bclswl0827/2k1000la-cape/hardware/pcb/gerber/pcb-PTH-drl_map.dxf

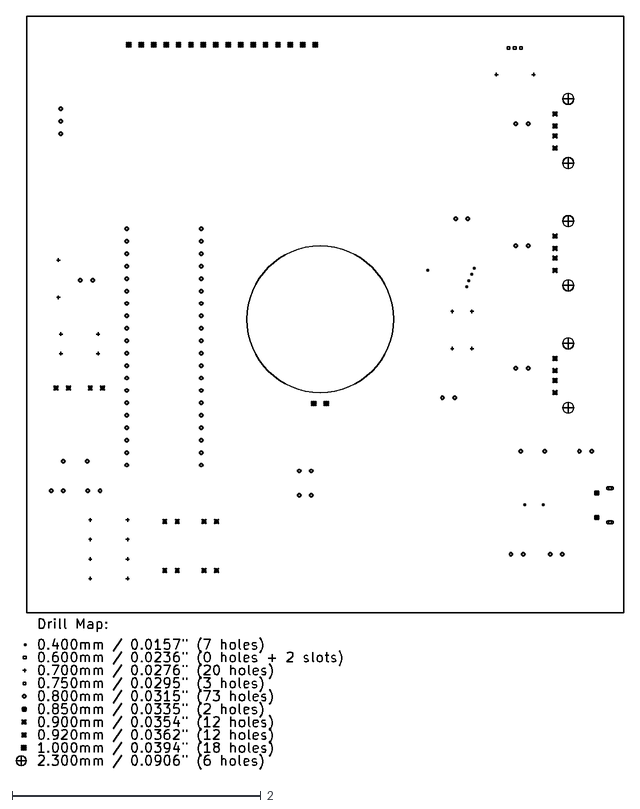
[picture p1: CAD file, 2024-06-12]
hardware/pcb/gerber/pcb-PTH-drl_map.dxf
4.88 x 6.06
