bclswl0827/2k1000la-cape/hardware/pcb/gerber/pcb-NPTH-drl_map.dxf

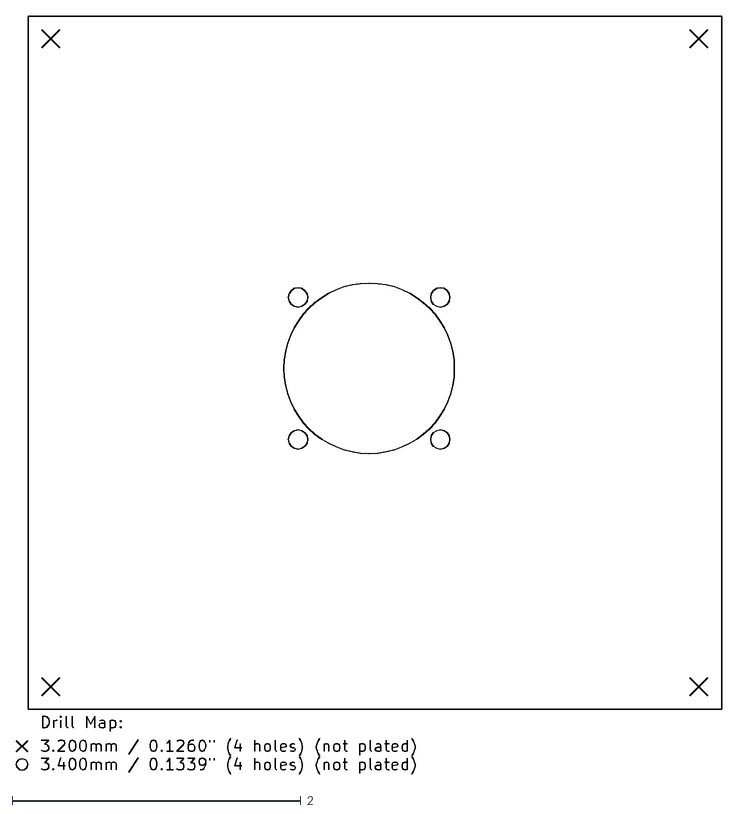
[picture p2: CAD file, 2024-06-12]
hardware/pcb/gerber/pcb-NPTH-drl_map.dxf
4.88 x 5.25
