bclswl0827/2k1000la-cape/hardware/pcb/pcb.kicad_pcb

## KiCad design hardware/pcb/pcb.kicad_pcb (2024-06-21)

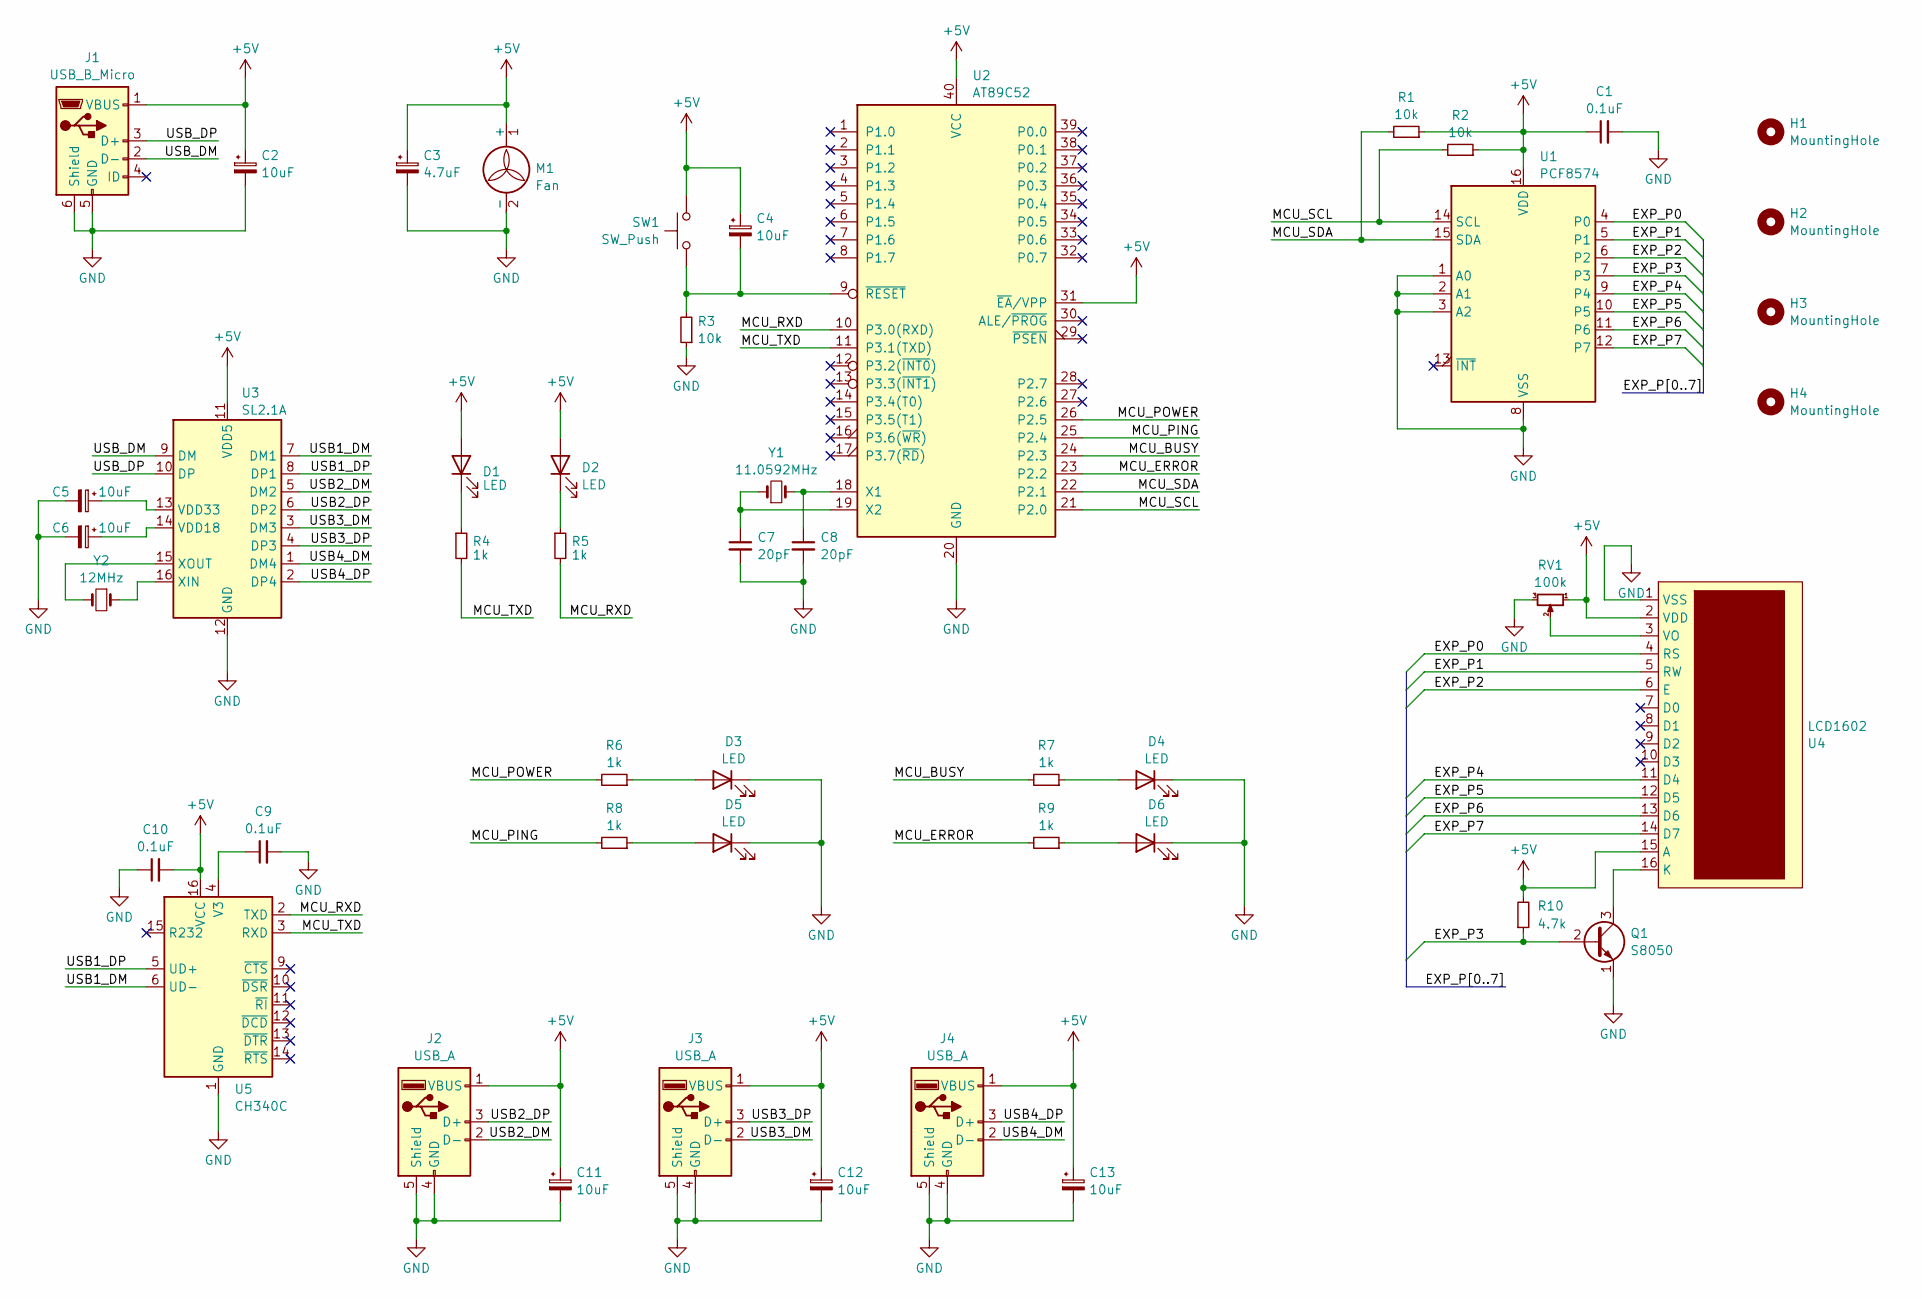
[picture p3: schematic pcb.kicad_sch]

Parts:
C1, C9, C10: 0.1uF; C_Disc_D3.0mm_W2.0mm_P2.50mm
C2, C4, C5, C6, C11, C12, C13: 10uF; CP_Radial_D5.0mm_P2.50mm
C3: 4.7uF; CP_Radial_D5.0mm_P2.50mm
C7, C8: 20pF; C_Disc_D3.0mm_W2.0mm_P2.50mm
D1, D2, D3, D4, D5, D6: LED; LED_D3.0mm
H1, H2, H3, H4: MountingHole; MountingHole_3.2mm_M3
J1: USB_B_Micro; USB_Micro-B_Molex-105017-0001
J2, J3, J4: USB_A; USB_A_CONNFLY_DS1095-WNR0
M1: Fan; Fan_30x30mm
Q1: S8050; TO-92_Inline
R1, R2, R3: 10k; R_Axial_DIN0204_L3.6mm_D1.6mm_P7.62mm_Horizontal
R4, R5, R6, R7, R8, R9: 1k; R_Axial_DIN0204_L3.6mm_D1.6mm_P7.62mm_Horizontal
R10: 4.7k; R_Axial_DIN0204_L3.6mm_D1.6mm_P7.62mm_Horizontal
RV1: 100k; Potentiometer_Bourns_3296W_Vertical
SW1: SW_Push; SW_SPST_FSMSM
U1: PCF8574; SOIC-16W_7.5x10.3mm_P1.27mm
U2: AT89C52; DIP-40_W15.24mm
U3: SL2.1A; SOIC-16_3.9x9.9mm_P1.27mm
U4: LCD1602; PinSocket_1x16_P2.54mm_Vertical
U5: CH340C; SOIC-16_3.9x9.9mm_P1.27mm
Y1: 11.0592MHz; Crystal_HC18-U_Vertical
Y2: 12MHz; Crystal_HC18-U_Vertical

Connections:
+5V: C1.1, C2.1, C3.1, C4.1, C10.2, C11.1, C12.1, C13.1, D1.2 (A), D2.2 (A), J1.1 (VBUS), J2.1 (VBUS), J3.1 (VBUS), J4.1 (VBUS), M1.1 (+), R1.1, R2.1, R10.2, RV1.1, SW1.1, U1.16 (VDD), U2.31 (~EA/VPP), U2.40 (VCC), U3.11 (VDD5), U4.2 (VDD), U4.15 (A), U5.16 (VCC)
/EXP_P0: U1.4 (P0), U4.4 (RS)
/EXP_P1: U1.5 (P1), U4.5 (RW)
/EXP_P2: U1.6 (P2), U4.6 (E)
/EXP_P3: Q1.2 (B), R10.1, U1.7 (P3)
/EXP_P4: U1.9 (P4), U4.11 (D4)
/EXP_P5: U1.10 (P5), U4.12 (D5)
/EXP_P6: U1.11 (P6), U4.13 (D6)
/EXP_P7: U1.12 (P7), U4.14 (D7)
/MCU_BUSY: R7.2, U2.24 (P2.3)
/MCU_ERROR: R9.2, U2.23 (P2.2)
/MCU_PING: R8.2, U2.25 (P2.4)
/MCU_POWER: R6.2, U2.26 (P2.5)
/MCU_RXD: R5.2, U2.10 (P3.0(RXD)), U5.2 (TXD)
/MCU_SCL: R2.2, U1.14 (SCL), U2.21 (P2.0)
/MCU_SDA: R1.2, U1.15 (SDA), U2.22 (P2.1)
/MCU_TXD: R4.2, U2.11 (P3.1(TXD)), U5.3 (RXD)
/USB1_DM: U3.7 (DM1), U5.6 (UD-)
/USB1_DP: U3.8 (DP1), U5.5 (UD+)
/USB2_DM: J2.2 (D-), U3.5 (DM2)
/USB2_DP: J2.3 (D+), U3.6 (DP2)
/USB3_DM: J3.2 (D-), U3.3 (DM3)
/USB3_DP: J3.3 (D+), U3.4 (DP3)
/USB4_DM: J4.2 (D-), U3.1 (DM4)
/USB4_DP: J4.3 (D+), U3.2 (DP4)
/USB_DM: J1.2 (D-), U3.9 (DM)
/USB_DP: J1.3 (D+), U3.10 (DP)
GND: C1.2, C2.2, C3.2, C5.2, C6.2, C7.2, C8.2, C9.2, C10.1, C11.2, C12.2, C13.2, D3.1 (K), D4.1 (K), D5.1 (K), D6.1 (K), J1.5 (GND), J1.6 (Shield), J2.4 (GND), J2.5 (Shield), J3.4 (GND), J3.5 (Shield), J4.4 (GND), J4.5 (Shield), M1.2 (-), Q1.1 (E), R3.1, RV1.3, U1.1 (A0), U1.2 (A1), U1.3 (A2), U1.8 (VSS), U2.20 (GND), U3.12 (GND), U4.1 (VSS), U5.1 (GND)
unnamed: D1.1 (K), R4.1
unnamed: D2.1 (K), R5.1
unnamed: D3.2 (A), R6.1
unnamed: D4.2 (A), R7.1
unnamed: D5.2 (A), R8.1
unnamed: D6.2 (A), R9.1
unnamed: Q1.3 (C), U4.16 (K)
unnamed: C8.1, U2.18 (X1), Y1.2
unnamed: C7.1, U2.19 (X2), Y1.1
unnamed: C4.2, R3.2, SW1.2, U2.9 (~RESET)
unnamed: C6.1, U3.14 (VDD18)
unnamed: C5.1, U3.13 (VDD33)
unnamed: U3.16 (XIN), Y2.1
unnamed: U3.15 (XOUT), Y2.2
unnamed: RV1.2, U4.3 (VO)
unnamed: C9.1, U5.4 (V3)

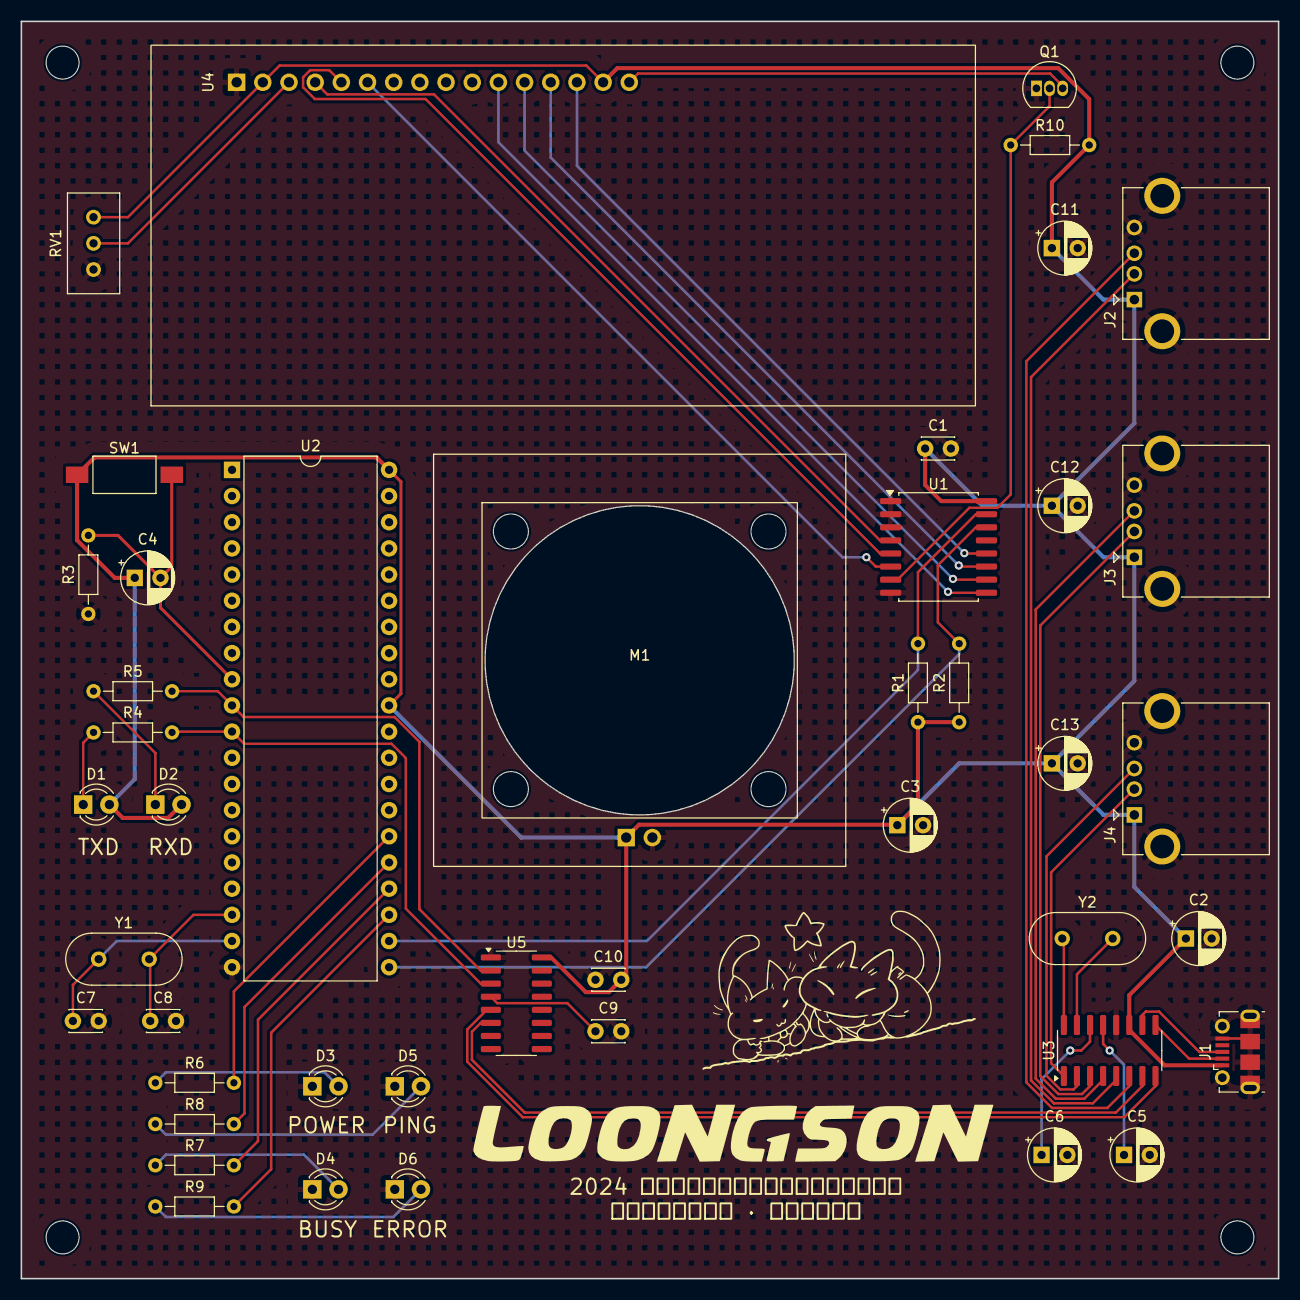
[picture p4: board pcb.kicad_pcb from above]

Board: 2 copper layers, 122.0 x 122.0 mm, 48 parts (0 on the bottom side), 44 nets.
