bclswl0827/2k1000la-cape/(commit log)

2024-06-17 Print timeout message when no data received
2024-06-17 Adjust timer
2024-06-21 Update KiCAD to 8.0
    [pcb-B_Cu.gbr, pcb-B_Mask.gbr, pcb-B_Paste.gbr, pcb-B_Silkscreen.gbr, pcb-Edge_Cuts.gbr, pcb-F_Cu.gbr, pcb-F_Mask.gbr, pcb-F_Paste.gbr]
2024-12-22 chore: Update startup message
    [pcb.kicad_sch]
